fredlee590/LightStick/README.md

# LightStick

A short stick with LEDs and an IMU in it. Modulate, change color, etc based on movement. Should be a good show.
