fredlee590/LightStick/Hardware/PCB/LightStickAccelerometer/plan/LightStickAccelerometerBlockDiagram.png

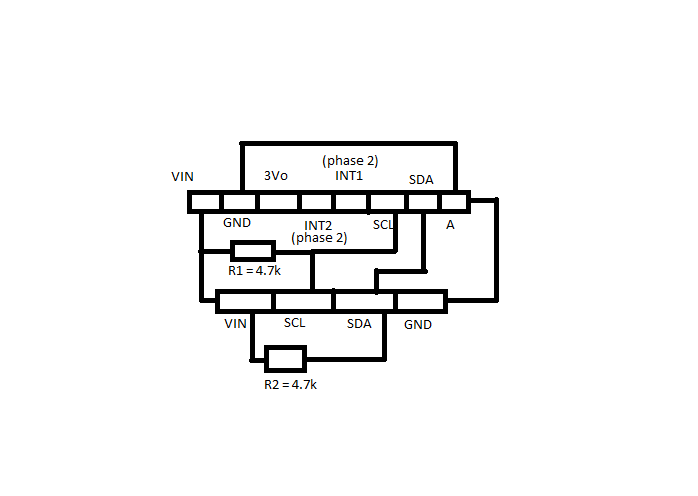
Hardware/PCB/LightStickAccelerometer/plan/LightStickAccelerometerBlockDiagram.png
