fredlee590/LightStick/Hardware/PCB/LightStickButton/LightStickButtonBlockDiagram.png

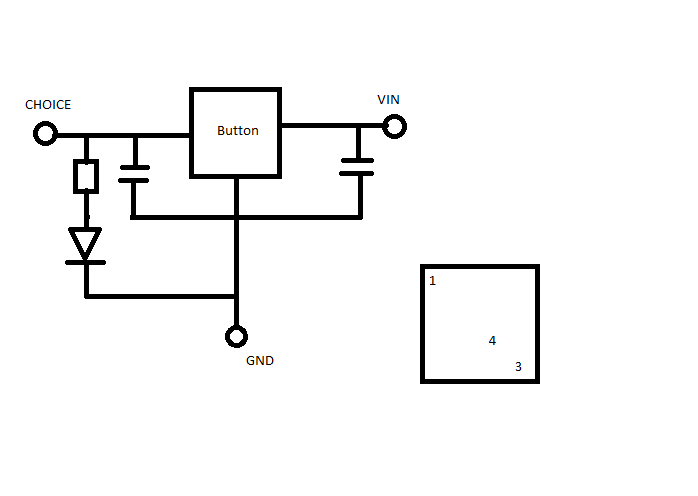
Hardware/PCB/LightStickButton/LightStickButtonBlockDiagram.png
