fredlee590/LightStick/Hardware/PCB/LightStickControl/plan/BlockDiagram_LightStickControl.png

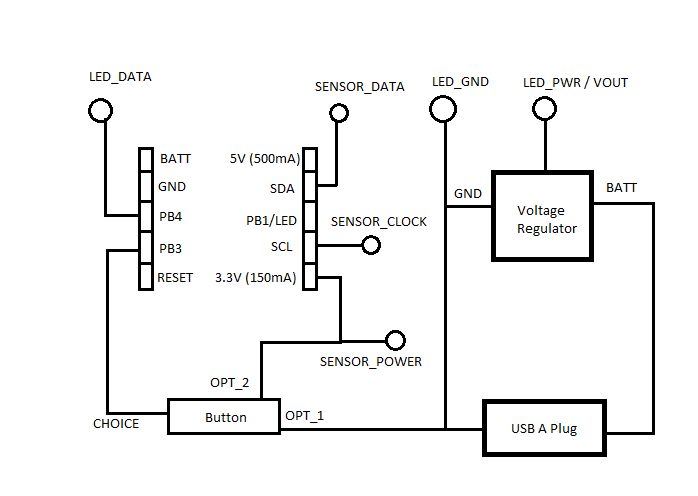
Hardware/PCB/LightStickControl/plan/BlockDiagram_LightStickControl.png
