fredlee590/LightStick/Hardware/Structure/LightStickLEDBlade/plan/LightStickLEDBladeBasicBlockDiagram.png

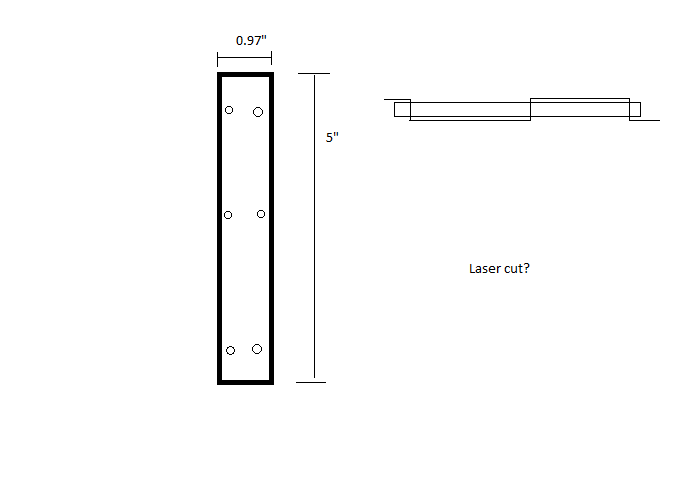
Hardware/Structure/LightStickLEDBlade/plan/LightStickLEDBladeBasicBlockDiagram.png
