fredlee590/LightStick/Hardware/Structure/LightStickLEDBlade/plan/LightStickLEDBladeBlockDiagram.png

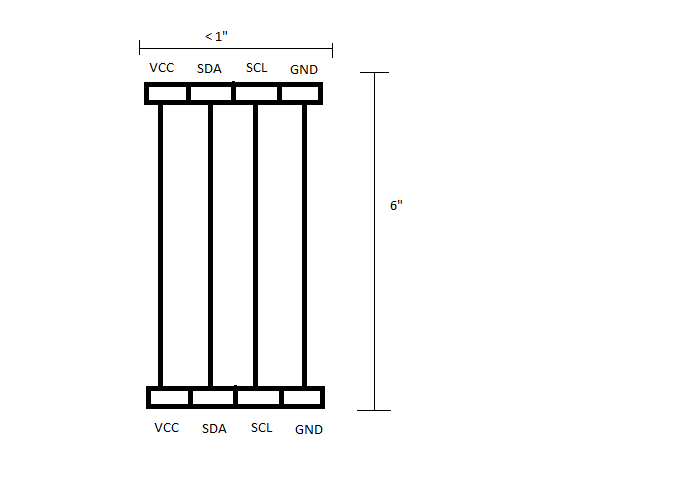
Hardware/Structure/LightStickLEDBlade/plan/LightStickLEDBladeBlockDiagram.png
