fredlee590/LightStick/Hardware/PCB/LightStickControl/plan/BoM_LightStickControl.xlsx

Manufacturer | Manufacturer ID | Role | Vendor | Vendor ID | Quantity | Price Per Unit | Price | Datasheet PDF Name | Notes
Adafruit | Trinket | Microcontroller | Adafruit | 1500 | 1 | 6.95 | 6.95 | Atmel-2586-AVR-8-bit-Microcontroller-ATtiny25-ATtiny45-ATtiny85_Datasheet | Microcontroller on the trinket
Keystone Electronics | 932 | USB A Interface | Digikey | 36-932-ND | 1 | 1.16 | 1.16 | 932
Diodes Incorporated | AP2114H-3.3TRG1 | LED power converter | Digikey | AP2114H-3.3TRG1DICT-ND | 1 | 0.36 | 0.36 | AP2114
Samsung | CL10B475KQ8NQNC | Debouncing Capacitor | Digikey | 1276-2087-1-ND | 4 | 0.1 | 0.4 | CL_Series_MLCC_ds | 603 footprint
Sullins | PREC040SAAN-RC | Male headers for MCU | Digikey | S1012EC-40-ND | 2 | 0.56 | 1.12 | z RzCzzzSzzN-RC, ST,11635-B
C&K | KS12R22CQD | Mode Change Button | Digikey | CKN1595-ND | 1 | 2.16 | 2.16 | ks | On-Mom
 |  |  |  |  |  | Total Price | 12.15
