fredlee590/LightStick/Hardware/3DPrinting/TipCap.FCStd

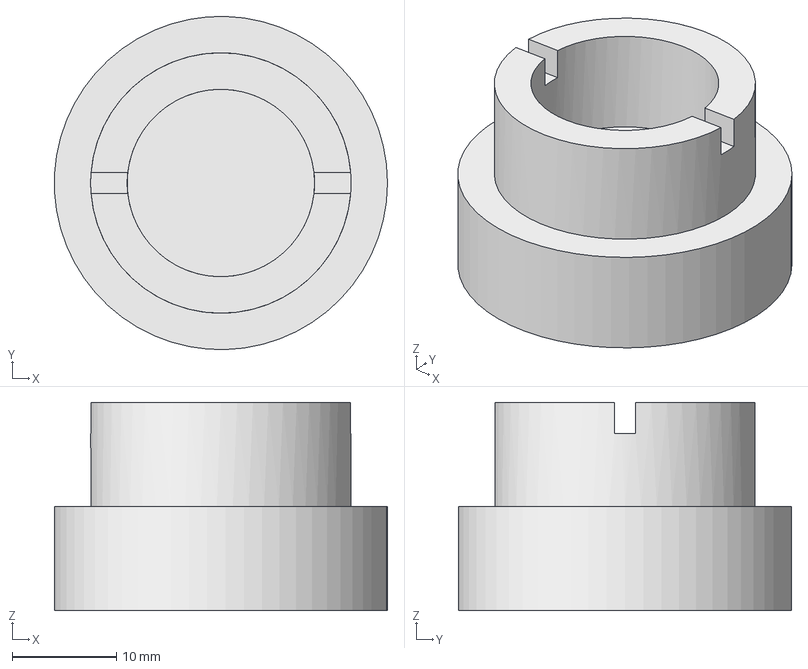
[picture p6: CAD file, 2017-04-28]
Hardware/3DPrinting/TipCap.FCStd
32.0 x 32.0 x 20.0 mm
