fredlee590/LightStick/Hardware/3DPrinting/BatteryStopper.FCStd

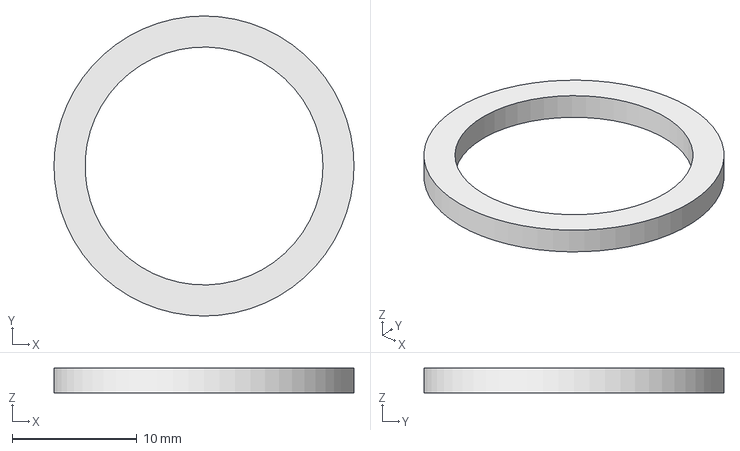
[picture p7: CAD file, 2017-04-17]
Hardware/3DPrinting/BatteryStopper.FCStd
24.0 x 24.0 x 2.00 mm
