fredlee590/LightStick/Hardware/PCB/LightStickControl/kicad_files/LightStickControl.kicad_pcb

## KiCad design Hardware/PCB/LightStickControl/kicad_files/LightStickControl.kicad_pcb (2023-12-28)

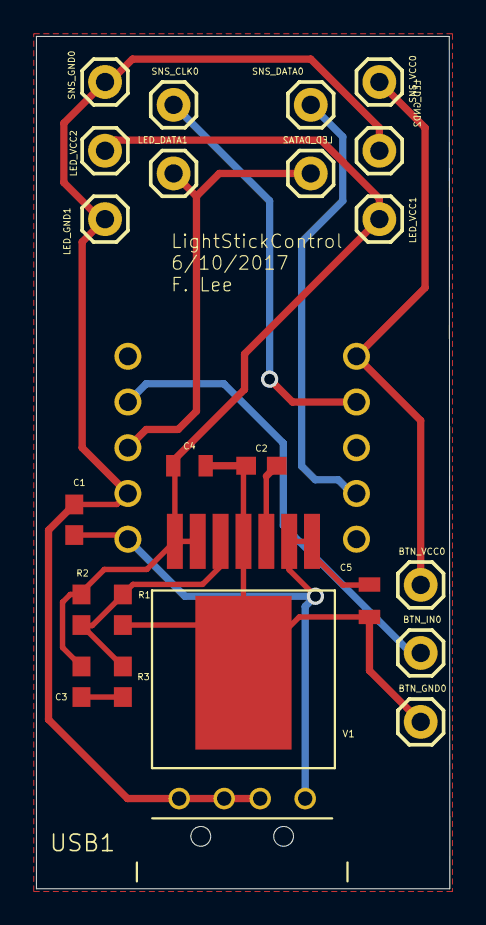
[picture p8: board LightStickControl.kicad_pcb from above]

Board: 2 copper layers, 23.0 x 47.3 mm, 24 parts (1 on the bottom side), 11 nets.

Parts:
BTN_GND0: 1X01
BTN_IN0: 1X01
BTN_VCC0: 1X01
C1: 4.7uF; 0603
C2: 10nF; 0603
C3: 100pF; 0603
C4: 47uF; 0805
C5: 22uF; 0805
LED_DATA1, LED_DATA2: 1X01
LED_GND1, LED_GND2: 1X01
LED_VCC1, LED_VCC2: 1X01
MCU1: ARDUINO_TRINKET
R1: 33k; 0603
R2: 100k; 0603
R3: 4.53k; 0603
SNS_CLK0: 1X01
SNS_DATA0: 1X01
SNS_GND0: 1X01
SNS_VCC0: 1X01
USB1: USB_A_932
V1: LMZ10503; TO-PMOD

Connections:
BTN_IN: BTN_IN0.1, MCU1.PB3
FB: R1.2, R2.1, R3.2, V1.FB
GND: BTN_GND0.1, C1.2, C2.1, C4.2, C5.2, LED_GND1.1, LED_GND2.1, MCU1.GND, R1.1, SNS_GND0.1, USB1.D+, USB1.D-, USB1.GND, V1.GND, V1.GND_PAD
LED_DATA: LED_DATA1.1, LED_DATA2.1, MCU1.PB4
SNS_CLK: MCU1.PB2, SNS_CLK0.1
SNS_DATA: MCU1.PB0, SNS_DATA0.1
SNS_VCC: BTN_VCC0.1, MCU1.3.3V, SNS_VCC0.1
SS: C2.2, V1.SS
VCC_IN: C1.1, C5.1, MCU1.BATT, USB1.VCC, V1.EN, V1.VIN
VOUT: C3.2, C4.1, LED_VCC1.1, LED_VCC2.1, R2.2, V1.VOUT1, V1.VOUT2
VOUT_C: C3.1, R3.1
