fredlee590/LightStick/Hardware/PCB/LightStickButton/LightStickButton/LightStickButton.brd

## EAGLE design Hardware/PCB/LightStickButton/LightStickButton/LightStickButton.brd (2017-05-23)

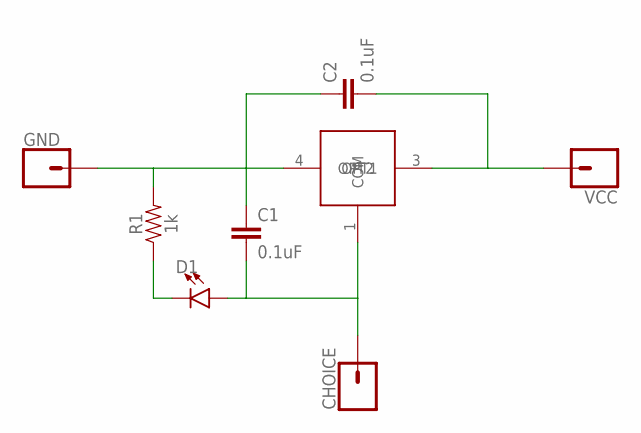
[picture p11: schematic LightStickButton.sch]

Parts:
B1: KS12R22CQD
C1, C2: 0.1uF; 0603
CHOICE: CONN_01; 1X01
D1: LED0603; LED-0603
GND: CONN_01; 1X01
R1: 1k; 0603
VCC: CONN_01; 1X01

Connections:
unnamed: B1.4 (OPT2), C1.1, C2.1, GND.1, R1.2
unnamed: B1.3 (OPT1), C2.2, VCC.1
unnamed: B1.1 (COM), C1.2, CHOICE.1, D1.A
unnamed: D1.C, R1.1

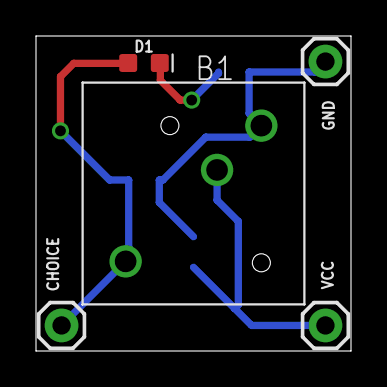
[picture p12: board LightStickButton.brd from above]

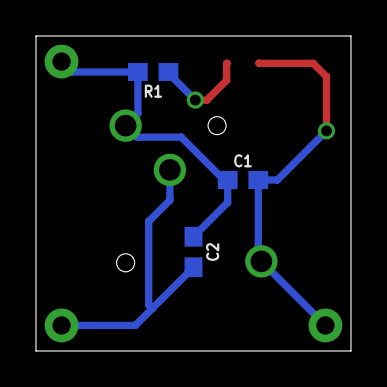
[picture p13: board LightStickButton.brd from below]

Board: 2 copper layers, 17.5 x 17.5 mm, 8 parts (3 on the bottom side), 4 nets.
