fredlee590/LightStick/Hardware/PCB/LightStickAccelerometer/LightStickAccelerometer/LightStickAccelerometer.brd

## EAGLE design Hardware/PCB/LightStickAccelerometer/LightStickAccelerometer/LightStickAccelerometer.brd (2017-04-29)

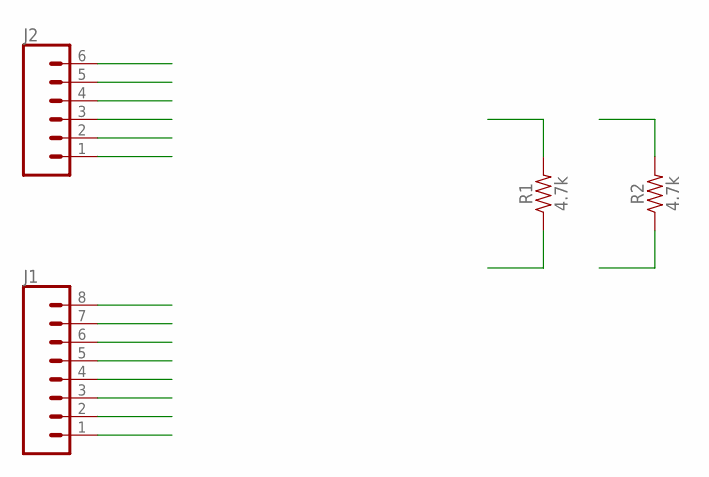
[picture p14: schematic LightStickAccelerometer.sch]

Parts:
J1: CONN_08"; 1X08
J2: CONN_06SILK_FEMALE_PTH; 1X06
R1, R2: 4.7k; 0603

Connections:
3VO: J1.3
GND: J1.2, J1.8, J2.6
INT1: J1.5, J2.5
INT2: J1.4, J2.4
SCL: J1.6, J2.2, R2.1
SDA: J1.7, J2.3, R1.1
VIN: J1.1, J2.1, R1.2, R2.2

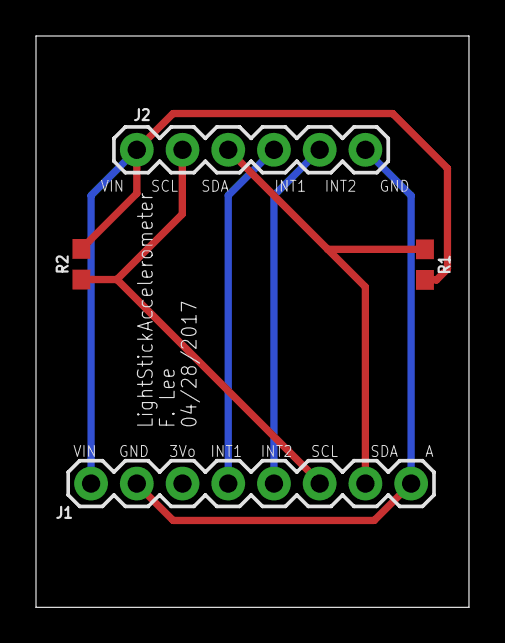
[picture p15: board LightStickAccelerometer.brd from above]

Board: 2 copper layers, 24.1 x 31.7 mm, 4 parts (0 on the bottom side), 6 nets.
