fredlee590/LightStick/(commit log)

2017-03-08 Initial check in of LightStick project. Move to new format of Github.
    [BoM_LightStickControl.xlsx, LightStickControl.brd, LightStickControl.sch]
2017-03-08 First cut of board layout. Add connectors. Label everything.
    [LightStickControl.brd, LightStickControl.sch]
2017-03-09 Add support components and lay initial placement.
    [LightStickControl.brd, LightStickControl.sch]
2017-03-09 Added routing.
    [LightStickControl.brd]
2017-04-12 Shorten PCB to allow for a snug fit for the USB plug A
    [LightStickControl.brd]
2017-04-17 Add 3D printed parts to maintain circuit board cohesion.
    [BatteryStopper.FCStd, TipCap.FCStd]
2017-04-19 Rebuild Tip Cap.
    [TipCap.FCStd]
2017-04-19 Add folder for accelerometer PCB
2017-04-20 Planning for physical build out of the Light Stick blade and accelerometer circuit.
2017-04-20 Move LightStick blade from PCB directory to Laser cutting directory.
2017-04-28 Add LightStickAccelerometer schematic and board. Update eagle project file accordingly.
    [LightStickAccelerometer.brd, LightStickAccelerometer.sch]
2017-04-28 Add slot for PCB
    [TipCap.FCStd]
2017-04-28 Adjust PCB bounds.
2017-04-29 Move components to allow for some empty space on top and bottom.
    [LightStickAccelerometer.brd]
2017-04-29 Use Laen's design rules in design rule check.
    [LightStickAccelerometer.brd]
2017-05-08 Rename LaserCutting to reflect ends rather than means.
2017-05-08 Plan out Light stick button PCB.
2017-05-10 Create PCB for LightStick button.
    [LightStickButton.brd, LightStickButton.sch]
2017-05-23 LightStickButton fixes. Holes moved to proper mirrored places. Through-holes widened.
    [LightStickButton.brd, LightStickButton.sch]
2017-06-12 Add new switching voltage regulator.
    [LightStickControl.brd, LightStickControl.sch]
2017-06-12 Add ground plane to top layer.
    [LightStickControl.brd]
2017-06-29 Initial check in of accelerometer proof of concept. Can use it in lightweight manner. Add todo.
2019-10-14 Initial check in of basic Light Stick sketch
    Initial check in of simplest Light Stick sketch to use accelerometer in
    color determination.
2023-12-28 Import to KiCad
    Convert Eagle files into KiCad files for further development.
    [LightStickControl.kicad_pcb, LightStickControl.kicad_sch]
